Reynxldo/HealthBand/public/samuel.jpg

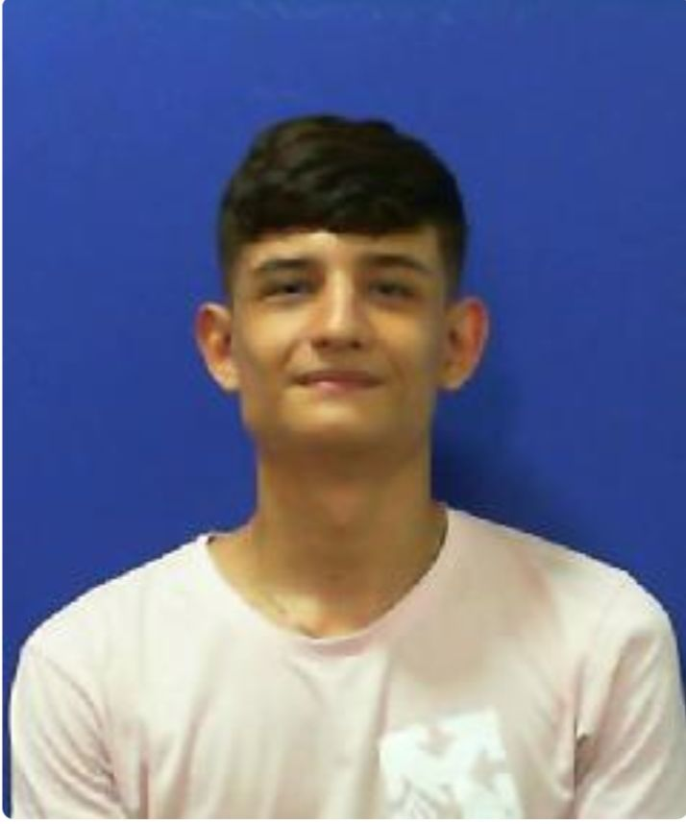
public/samuel.jpg
