Reynxldo/HealthBand/public/reynaldo.jpg

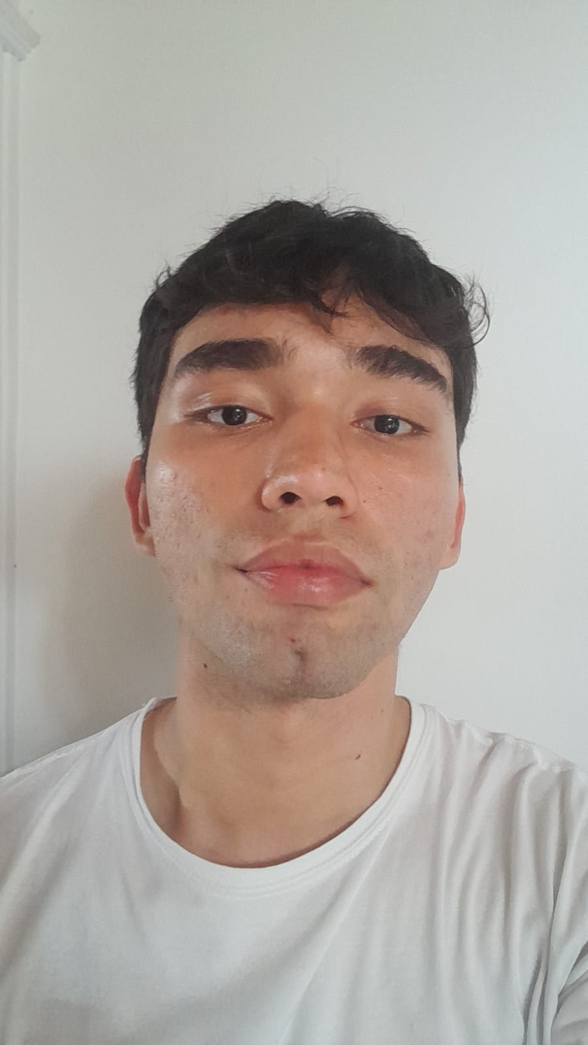
public/reynaldo.jpg
