Reynxldo/HealthBand/HealthBand_Proceso.docx

# Etapa 1 — Prueba Individual de Sensores

La primera etapa consistió en verificar el funcionamiento de cada sensor de forma independiente, antes de integrarlos en un mismo circuito.

## 1.1 Sensor MAX30100 (Ritmo Cardíaco y SpO2)

Se realizó la conexión básica del MAX30100 a la ESP32 mediante el bus I2C (GPIO 21 — SDA, GPIO 22 — SCL) con resistencias pull-up de 3.3kΩ hacia 3.3V. Se verificó que el sensor respondiera en la dirección I2C 0x57 mediante un sketch de escaneo de bus.

Se cargó un sketch de prueba con la librería MAX30100_PulseOximeter de OXullo, confirmando la inicialización correcta del sensor y la detección de latidos y SpO2 al colocar el dedo sobre el módulo. Se ajustó la corriente del LED infrarrojo a 27.1mA como valor óptimo entre precisión y temperatura del sensor.

Durante esta etapa se identificó que el módulo MAX30100 tiene resistencias pull-up internas a 1.8V, lo que generaría conflictos al compartir el bus I2C con el MLX90614 que opera a 3.3V.

## 1.2 Sensor MLX90614 (Temperatura Corporal)

Se realizó la conexión del MLX90614 al mismo bus I2C de prueba, verificando su respuesta en la dirección 0x5A. Se confirmó la lectura de temperatura ambiente y temperatura de objeto apuntando el sensor a diferentes superficies.

Se determinó que el sensor requiere un offset de +1.5°C para compensar la diferencia entre la temperatura superficial medida en muñeca y la temperatura corporal real, dado que la muñeca es una zona periférica con menor irrigación sanguínea.

# Etapa 2 — Integración de Ambos Sensores

Una vez verificados individualmente, se procedió a integrar ambos sensores en el mismo circuito conectados a la ESP32 simultáneamente.

## 2.1 Problema de Bus I2C Compartido

Al conectar ambos sensores al mismo bus I2C (GPIO 21/22), se presentaron conflictos generados por la diferencia de voltaje en las resistencias pull-up internas del MAX30100 (1.8V) frente a los niveles lógicos del MLX90614 (3.3V). Esto causaba que el MLX reportara valores NaN y que el MAX dejara de responder.

Se evaluaron varias soluciones incluyendo la remoción de resistencias internas del módulo MAX30100 y el uso de convertidores de nivel lógico. La solución definitiva adoptada fue el uso de dos buses I2C independientes en la ESP32.

## 2.2 Solución con Buses I2C Separados

Se configuró el MAX30100 en el Bus 0 (Wire, GPIO 21/22) y el MLX90614 en el Bus 1 (TwoWire(1), GPIO 25/26). Esta configuración eliminó completamente los conflictos entre sensores, permitiendo la operación simultánea y estable de ambos dispositivos.

- MAX30100: SDA → GPIO 21, SCL → GPIO 22, resistencias pull-up 4.7kΩ a 3.3V.
- MLX90614: SDA → GPIO 25, SCL → GPIO 26, sin resistencias externas adicionales.

## 2.3 Optimización del Algoritmo de Medición

Para estabilizar las lecturas del MAX30100 en muñeca, se implementaron las siguientes mejoras en el firmware:

- Buffer circular de 10 muestras para el promedio de BPM, aceptando solo valores entre 40 y 130 BPM.
- Tiempo de estabilización de 15 segundos al arrancar, durante el cual no se generan alertas.
- Persistencia de anomalía de 5 segundos: una condición debe mantenerse continua antes de disparar alerta.
- Manejo del loop sin delay() usando millis() para no interrumpir pox.update().
- Variable alertaPendiente para publicar alertas MQTT en el ciclo de 10 segundos sin bloquear el loop.

# Etapa 3 — Configuración del Broker MQTT

Con los sensores funcionando en conjunto, se procedió a implementar la comunicación IoT mediante el protocolo MQTT.

## 3.1 Selección y Configuración de HiveMQ Cloud

Se seleccionó HiveMQ Cloud como broker MQTT por su plan gratuito serverless, alta disponibilidad y soporte de conexiones TLS en el puerto 8883. Se creó una cuenta y se configuraron las credenciales de acceso.

Se configuró la ESP32 con la librería PubSubClient y WiFiClientSecure para establecer conexiones MQTT sobre TLS sin verificación de certificado (setInsecure()), lo que simplifica la implementación sin comprometer la funcionalidad del prototipo.

## 3.2 Tópicos MQTT Definidos

- pulsera/bpm — promedio de BPM de las últimas 10 muestras válidas.
- pulsera/spo2 — saturación de oxígeno en porcentaje.
- pulsera/temperatura — temperatura con offset aplicado.
- pulsera/alerta — texto de la alerta cuando se detecta una anomalía.

## 3.3 Verificación

Se verificó la llegada de datos al broker mediante el panel web de HiveMQ, confirmando la publicación correcta de los cuatro tópicos. Se ajustó el intervalo de publicación a 10 segundos para evitar bloqueos en el loop principal de la ESP32.

# Etapa 4 — Servidor Node.js y Dashboard Web

Con la ESP32 publicando datos al broker, se desarrolló la capa de software que recibe, almacena y visualiza la información en tiempo real.

## 4.1 ¿Por qué Node.js?

Node.js fue seleccionado como plataforma del servidor backend por las siguientes razones:

- Arquitectura asíncrona y no bloqueante, ideal para manejar simultáneamente MQTT, WebSocket, HTTP y base de datos sin bloqueos.
- Ecosistema npm con librerías especializadas para IoT: mqtt, express, ws y sqlite3, instalables con un solo comando.
- Uso de un único lenguaje (JavaScript) tanto en el servidor como en el frontend del dashboard.
- Bajo consumo de recursos, adecuado para correr en el mismo PC que sirve el dashboard.
- Soporte nativo de WebSockets para comunicación en tiempo real con el navegador sin polling.

## 4.2 Implementación del Servidor

Se desarrolló el archivo servidor.js integrando las siguientes funcionalidades en un único proceso:

- Cliente MQTT suscrito al tópico pulsera/# para recibir todos los datos de la ESP32.
- Base de datos SQLite con tablas para lecturas (bpm, spo2, temperatura, timestamp) y alertas.
- Servidor HTTP con Express sirviendo el dashboard en el puerto 3000 y una API REST en /api/historial y /api/alertas.
- Servidor WebSocket que reenvía en tiempo real los datos recibidos de MQTT a todos los clientes conectados.
- Bot de Telegram que envía notificaciones HTTP a la API de Telegram cuando llega una alerta.

## 4.3 Gestión con PM2

El servidor se configuró con PM2 (Process Manager 2) con un límite de reinicio automático de 150MB de memoria, evitando que una saturación del proceso interrumpa el monitoreo. Se configuró el arranque automático mediante un archivo arrancar.bat en la carpeta de inicio de Windows.

## 4.4 Dashboard Web — Primera Versión

Se desarrolló el dashboard en HTML5, CSS3 y JavaScript vanilla, sin frameworks adicionales. La primera versión incluía tres cards con valores en tiempo real (BPM, SpO2, temperatura), dos gráficas de línea con Chart.js mostrando las últimas 20 lecturas, y una tabla de historial consultada cada 10 segundos desde la API REST. La comunicación con el servidor se realizó mediante WebSocket con reconexión automática.

# Etapa 5 — Mejoras al Dashboard

Una vez validado el funcionamiento completo del sistema, se realizaron mejoras significativas al diseño y funcionalidad del dashboard web.

## 5.1 Sistema de Login

Se implementó una pantalla de login con autenticación simulada en el frontend, con tres usuarios predefinidos: admin (contraseña 1234), doctor (contraseña med123) y paciente (contraseña pac456). La pantalla incluye accesos rápidos mediante chips de usuario para facilitar las demostraciones.

## 5.2 Navegación por Secciones

Se agregó una barra de navegación superior con tres secciones accesibles sin recargar la página:

- Monitoreo: dashboard principal con cards, gráficas e historial en tiempo real.
- Recomendaciones médicas: guía de acción ante cada tipo de alerta del sistema (BPM elevado, SpO2 crítico, hipotermia, temperatura elevada) con aviso médico.
- Contáctanos: información de los tres integrantes del equipo y datos de la Universidad Surcolombiana.

## 5.3 Mejoras de Diseño

Se rediseñó completamente la interfaz con un esquema de colores oscuro profesional, tipografías Space Mono y DM Sans, cards con efectos de brillo por sensor, gráficas con colores diferenciados, historial con colores por columna y animaciones de transición en el login. El nombre del sistema en la interfaz web es VitalCore, mientras que el nombre del prototipo físico es HealthBand.

# Etapa 6 — Prueba de Alimentación Portátil

La etapa final consistió en validar el funcionamiento del sistema con alimentación de batería, de cara al prototipo portátil final.

Se utilizó una batería Li-Po de 3.7V 1000mAh conectada a un módulo elevador MT3608 calibrado a 5.5V, cuya salida se conectó al pin VIN de la ESP32. Inicialmente el sistema presentaba inestabilidad en el arranque debido a la demanda de corriente pico al conectar WiFi (aproximadamente 500mA).

Se resolvió parcialmente agregando dos capacitores electrolíticos de 1000µF en paralelo a la salida del MT3608, que actúan como reserva de corriente instantánea durante el arranque. El sistema logró funcionar con batería, confirmado por la recepción de alertas en Telegram durante las pruebas.

Para el prototipo final se recomienda utilizar una batería de mayor capacidad (2000mAh o más) junto con el módulo cargador TP4056 de 6 pines para protección contra sobredescarga, como estaba planificado en el diseño original.

# Resumen de Etapas

# | Etapa | Resultado

1 | Prueba individual de sensores | MAX30100 y MLX90614 verificados por separado. Identificado conflicto de voltaje en bus I2C compartido.
2 | Integración de sensores | Solución con buses I2C separados. Firmware con promedio, estabilización y persistencia de alertas.
3 | Configuración broker MQTT | HiveMQ Cloud configurado. Cuatro tópicos publicados correctamente desde la ESP32.
4 | Servidor Node.js y dashboard | Servidor con MQTT, WebSocket, SQLite y Telegram. Dashboard con gráficas en tiempo real.
5 | Mejoras al dashboard | Login simulado, navegación por secciones, rediseño visual completo.
6 | Prueba de alimentación portátil | Sistema funcionando con batería Li-Po + MT3608 + capacitores. Pendiente batería 2000mAh para versión final.

Universidad Surcolombiana — Ingeniería Electrónica — 2025

HealthBand — Proceso de Desarrollo
