Reynxldo/HealthBand/Proyecto_salud.docx

PROYECTO FINAL

MONITOREO DE SIGNOS VITALES CON IOT Y ESP32

CON PULSERA PORTABLE:

HEALTHYBAND

Reynaldo Medina Cabrera 20241221327

Juan Andrés Urrea Cediel 20241223061

Samuel Pérez Chinchilla 20241222057

Resumen-

Palabras claves-

REFERENCIAS:

Proyecto: HealthyBand P R O G R A M A D E I N G E N I E R I A E L E C T R O N I C A

F A C U L T A D D E I N G E N I E R I A 20 DE MARZO DEL 2026
