Reynxldo/HealthBand/public/juan.jpg

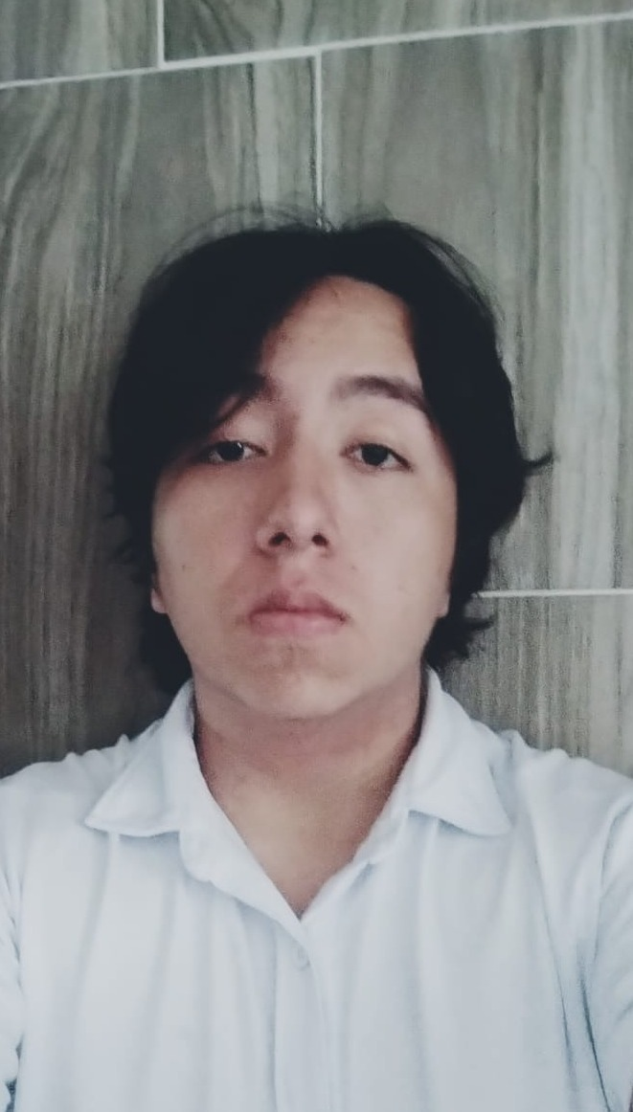
public/juan.jpg
