Reynxldo/HealthBand/HEALTH BAND_FINAL.pdf

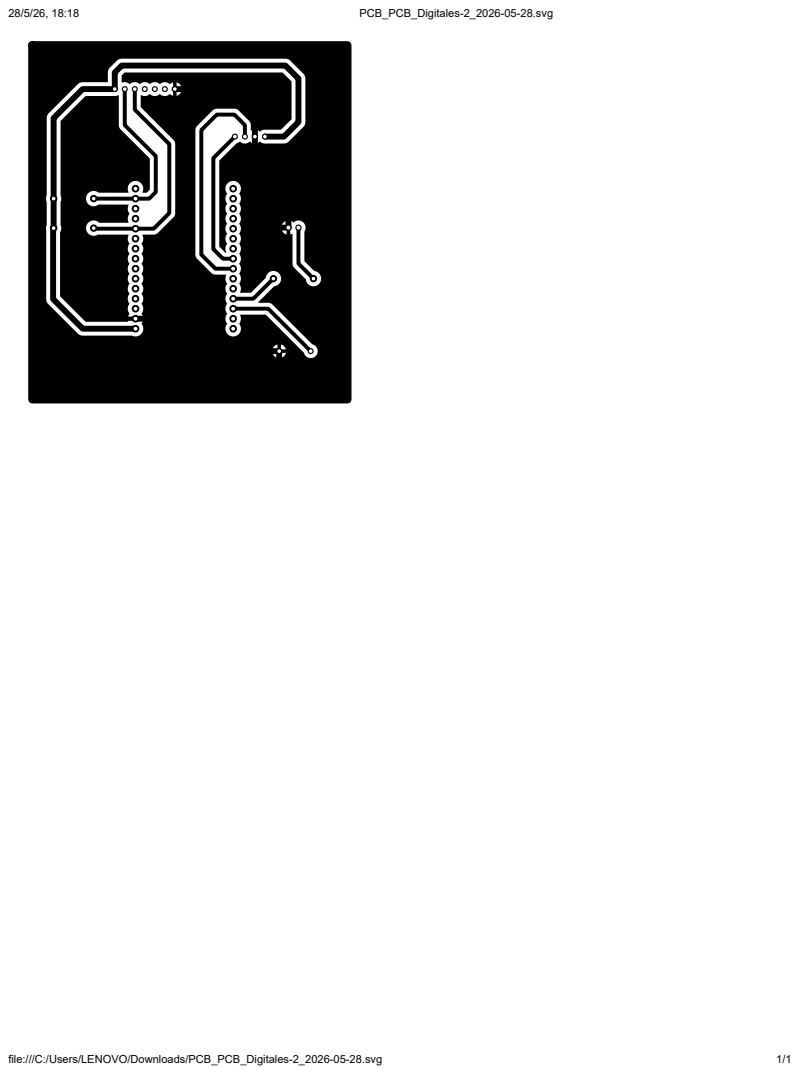
[picture p4: page 1]
PCB_PCB_Digitales-2_2026-05-28.svg; file:///C:/Users/LENOVO/Downloads/PCB_PCB_Digitales-2_2026-05-28.svg
