Reynxldo/HealthBand/PCB_HEALTH.pdf

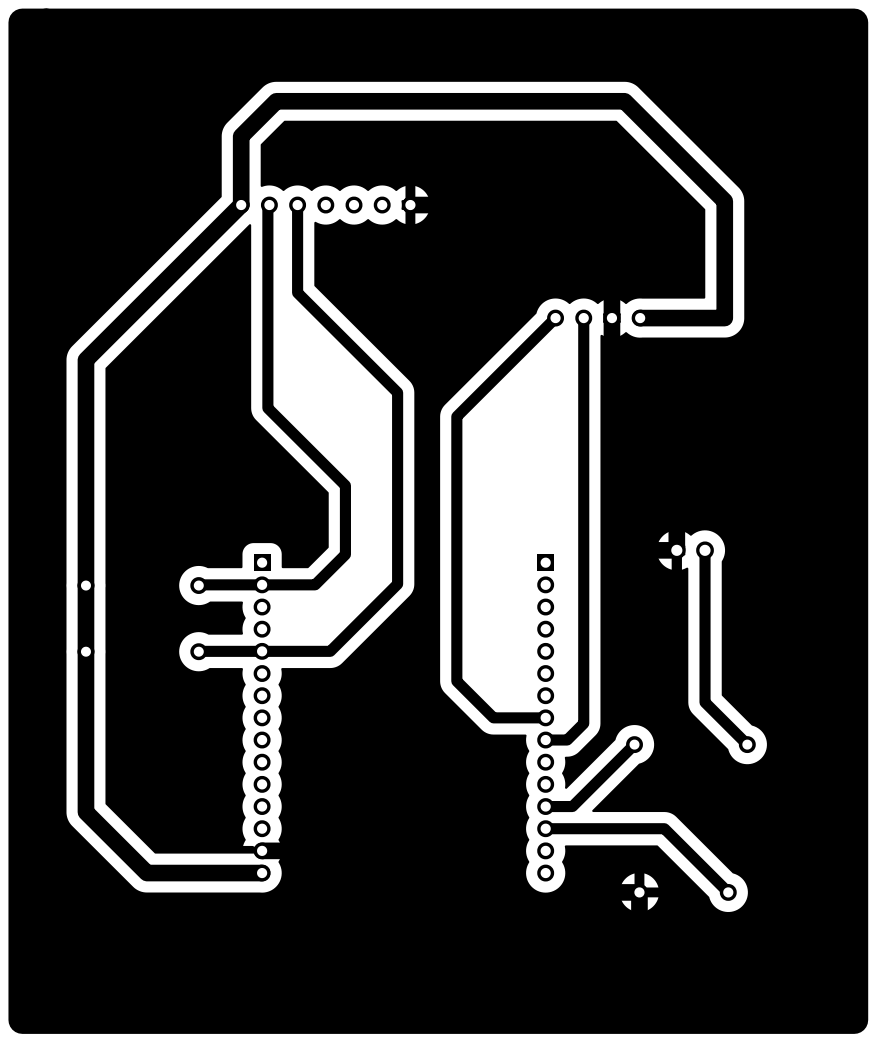
[picture p5: page 1]
