Reynxldo/HealthBand/placa_1.pdf

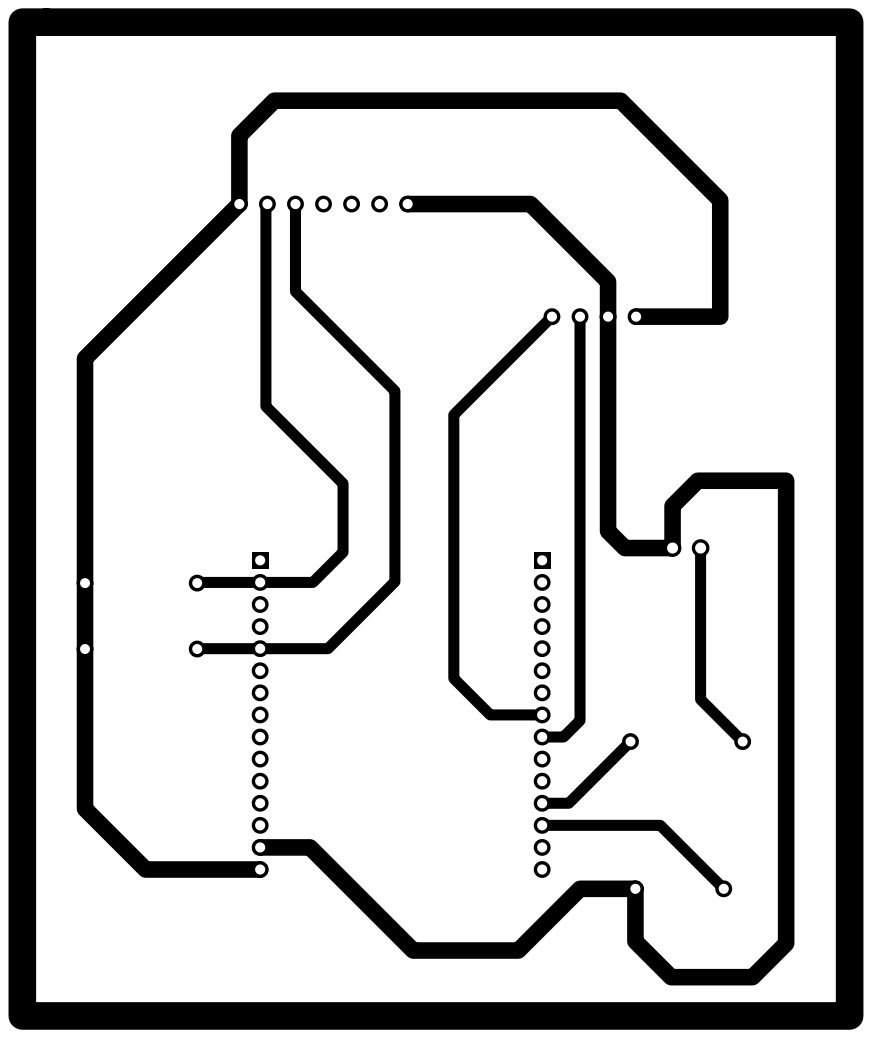
[picture p6: page 1]
