Reynxldo/HealthBand/proto_7/proto_7.ino

#include <Wire.h>
#include <Adafruit_MLX90614.h>
#include "MAX30100_PulseOximeter.h"
#include <WiFi.h>
#include <PubSubClient.h>
#include <WiFiClientSecure.h>

// WiFi
const char* ssid     = "iPhone de Samuel";
const char* password = "samuel01";

// HiveMQ
const char* mqtt_server   = "561ca56c1b5a4b978b24893f8b8a49c4.s1.eu.hivemq.cloud";
const int   mqtt_port     = 8883;
const char* mqtt_user     = "Caozinho369";
const char* mqtt_password = "Yrc5P@bmFgEUEbD";

#define PIN_LED    12
#define PIN_BUZZER 13

TwoWire I2C_MLX = TwoWire(1);

Adafruit_MLX90614 mlx = Adafruit_MLX90614();
PulseOximeter pox;

WiFiClientSecure espClient;
PubSubClient client(espClient);

uint32_t lastReport      = 0;
uint32_t lastTempRead    = 0;
uint32_t lastBuzzer      = 0;
uint32_t tiempoInicio    = 0;
uint32_t lastMqttPublish = 0;
bool buzzerActivo        = false;
bool buzzerEstado        = false;
int  buzzerContador      = 0;

uint32_t inicioBpmAlto  = 0;
uint32_t inicioSpo2Bajo = 0;
uint32_t inicioTempAlta = 0;
uint32_t inicioTempBaja = 0;
bool bpmAltoActivo      = false;
bool spo2BajoActivo     = false;
bool tempAltaActiva     = false;
bool tempBajaActiva     = false;

String alertaPendiente = "";
volatile bool latidoDetectado = false;

#define TIEMPO_ESTABILIZACION  15000
#define TIEMPO_PERSISTENCIA     5000

float offset = 1.5;

#define BPM_MUESTRAS 10
float bpmBuffer[BPM_MUESTRAS] = {0};
int bpmIndex = 0;
int bpmCount = 0;

float ultimaBpm  = 0;
float ultimaSpo2 = 0;
float ultimaTemp = 0;

#define SPO2_MINIMO   90.0
#define BPM_MAXIMO   100.0
#define TEMP_MAXIMA   37.5
#define TEMP_MINIMA   34.8

void onBeatDetected() {
  latidoDetectado = true;
}

void alertaBuzzer() {
  if (buzzerActivo) return;
  buzzerActivo   = true;
  buzzerEstado   = true;
  buzzerContador = 0;
  lastBuzzer     = millis();
  digitalWrite(PIN_BUZZER, HIGH);
}

void manejarBuzzer() {
  if (!buzzerActivo) return;
  uint32_t ahora = millis();
  if (buzzerEstado && ahora - lastBuzzer > 300) {
    buzzerEstado = false;
    digitalWrite(PIN_BUZZER, LOW);
    lastBuzzer = ahora;
  } else if (!buzzerEstado && ahora - lastBuzzer > 200) {
    buzzerContador++;
    if (buzzerContador >= 2) {
      buzzerActivo = false;
      buzzerEstado = false;
      digitalWrite(PIN_BUZZER, LOW);
    } else {
      buzzerEstado = true;
      digitalWrite(PIN_BUZZER, HIGH);
      lastBuzzer = ahora;
    }
  }
}

float calcularPromedioBPM() {
  if (bpmCount == 0) return 0;
  float suma = 0;
  int total = min(bpmCount, BPM_MUESTRAS);
  for (int i = 0; i < total; i++) suma += bpmBuffer[i];
  return suma / total;
}

bool sistemaEstabilizado() {
  return (millis() - tiempoInicio) >= TIEMPO_ESTABILIZACION;
}

void conectarWifi() {
  Serial.print("Conectando a WiFi");
  WiFi.begin(ssid, password);
  while (WiFi.status() != WL_CONNECTED) {
    delay(500);
    Serial.print(".");
  }
  Serial.println("\nWiFi conectado — IP: " + WiFi.localIP().toString());
}

void conectarMQTT() {
  espClient.setInsecure();
  client.setServer(mqtt_server, mqtt_port);
  client.setSocketTimeout(5);
  while (!client.connected()) {
    Serial.print("Conectando a HiveMQ...");
    String clientId = "ESP32Pulsera-" + String(random(0xffff), HEX);
    if (client.connect(clientId.c_str(), mqtt_user, mqtt_password)) {
      Serial.println(" conectado");
    } else {
      Serial.print(" fallo rc=");
      Serial.println(client.state());
      delay(2000);
    }
  }
}

void publicarMQTT() {
  if (!client.connected()) conectarMQTT();
  char buffer[10];
  dtostrf(ultimaBpm,  4, 1, buffer);
  client.publish("pulsera/bpm", buffer);
  dtostrf(ultimaSpo2, 4, 1, buffer);
  client.publish("pulsera/spo2", buffer);
  dtostrf(ultimaTemp, 4, 1, buffer);
  client.publish("pulsera/temperatura", buffer);
  Serial.println("→ Datos enviados a HiveMQ");
}

void verificarAnomaliaBpm(float bpmPromedio) {
  if (bpmPromedio > BPM_MAXIMO) {
    if (!bpmAltoActivo) {
      bpmAltoActivo = true;
      inicioBpmAlto = millis();
    } else if (millis() - inicioBpmAlto >= TIEMPO_PERSISTENCIA) {
      Serial.println("  → BPM elevado ⚠");
      alertaPendiente = "BPM elevado";
      alertaBuzzer();
      bpmAltoActivo = false;
      inicioBpmAlto = 0;
    }
  } else {
    bpmAltoActivo = false;
    inicioBpmAlto = 0;
  }
}

void verificarAnomaliaSpo2(float spo2) {
  if (spo2 > 0 && spo2 < SPO2_MINIMO) {
    if (!spo2BajoActivo) {
      spo2BajoActivo = true;
      inicioSpo2Bajo = millis();
    } else if (millis() - inicioSpo2Bajo >= TIEMPO_PERSISTENCIA) {
      Serial.println("  → SpO2 crítico ⚠");
      alertaPendiente = "SpO2 critico";
      alertaBuzzer();
      spo2BajoActivo = false;
      inicioSpo2Bajo = 0;
    }
  } else {
    spo2BajoActivo = false;
    inicioSpo2Bajo = 0;
  }
}

void verificarAnomaliaTemp(float temp) {
  if (temp > TEMP_MAXIMA) {
    if (!tempAltaActiva) {
      tempAltaActiva = true;
      inicioTempAlta = millis();
    } else if (millis() - inicioTempAlta >= TIEMPO_PERSISTENCIA) {
      Serial.println("  → Temperatura elevada ⚠");
      alertaPendiente = "Temperatura elevada";
      alertaBuzzer();
      tempAltaActiva = false;
      inicioTempAlta = 0;
    }
    tempBajaActiva = false;
    inicioTempBaja = 0;
  } else if (temp >= 20.0 && temp < TEMP_MINIMA) {
    if (!tempBajaActiva) {
      tempBajaActiva = true;
      inicioTempBaja = millis();
    } else if (millis() - inicioTempBaja >= TIEMPO_PERSISTENCIA) {
      Serial.println("  → Hipotermia ⚠");
      alertaPendiente = "Hipotermia";
      alertaBuzzer();
      tempBajaActiva = false;
      inicioTempBaja = 0;
    }
    tempAltaActiva = false;
    inicioTempAlta = 0;
  } else {
    tempAltaActiva = false;
    inicioTempAlta = 0;
    tempBajaActiva = false;
    inicioTempBaja = 0;
  }
}

void setup() {
  Serial.begin(115200);
  delay(1000);

  pinMode(PIN_LED,    OUTPUT);
  pinMode(PIN_BUZZER, OUTPUT);
  digitalWrite(PIN_LED,    HIGH);
  digitalWrite(PIN_BUZZER, LOW);

  conectarWifi();

  Wire.begin(21, 22);
  Wire.setClock(100000);

  if (!pox.begin()) {
    Serial.println("Error: MAX30100 no detectado");
    while (1);
  }
  pox.setIRLedCurrent(MAX30100_LED_CURR_27_1MA);
  pox.setOnBeatDetectedCallback(onBeatDetected);
  Serial.println("MAX30100 OK");

  delay(500);

  I2C_MLX.begin(25, 26);
  I2C_MLX.setClock(100000);

  if (!mlx.begin(0x5A, &I2C_MLX)) {
    Serial.println("Error: MLX90614 no detectado");
    while (1);
  }
  Serial.println("MLX90614 OK");

  conectarMQTT();

  tiempoInicio = millis();

  Serial.println("Sistema listo");
  Serial.println("------------------------");
}

void loop() {
  pox.update();
  manejarBuzzer();

  if (latidoDetectado) {
    Serial.println("♥ Latido");
    latidoDetectado = false;
  }

  if (millis() - lastReport > 1000) {
    float bpm  = pox.getHeartRate();
    float spo2 = pox.getSpO2();

    if (bpm >= 40 && bpm <= 130) {
      bpmBuffer[bpmIndex] = bpm;
      bpmIndex = (bpmIndex + 1) % BPM_MUESTRAS;
      bpmCount++;
    }

    float bpmPromedio = calcularPromedioBPM();
    ultimaBpm  = bpmPromedio;
    ultimaSpo2 = spo2;

    Serial.print("BPM: "); Serial.print(bpmPromedio, 1);
    Serial.print("  |  SpO2: "); Serial.print(spo2, 1); Serial.print(" %");

    if (bpm == 0) {
      Serial.println("  → Sin dedo");
      bpmCount       = 0;
      bpmIndex       = 0;
      bpmAltoActivo  = false;
      spo2BajoActivo = false;
    } else if (bpmPromedio == 0) {
      Serial.println("  → Leyendo...");
    } else if (bpmPromedio <= BPM_MAXIMO) {
      Serial.println("  → Normal");
      bpmAltoActivo = false;
    } else {
      if (sistemaEstabilizado()) {
        verificarAnomaliaBpm(bpmPromedio);
      } else {
        Serial.println("  → Estabilizando...");
      }
    }

    if (sistemaEstabilizado()) {
      verificarAnomaliaSpo2(spo2);
    }

    lastReport = millis();
  }

  if (millis() - lastTempRead > 2000) {
    float temp = mlx.readObjectTempC() + offset;
    ultimaTemp = temp;

    Serial.print("Temperatura: "); Serial.print(temp, 1); Serial.print(" °C");

    if (temp < 20.0) {
      Serial.println("  → Sin contacto");
      tempAltaActiva = false;
      tempBajaActiva = false;
    } else if (temp >= TEMP_MINIMA && temp <= TEMP_MAXIMA) {
      Serial.println("  → Normal");
      tempAltaActiva = false;
      tempBajaActiva = false;
    } else {
      if (sistemaEstabilizado()) {
        verificarAnomaliaTemp(temp);
      } else {
        Serial.println("  → Estabilizando...");
      }
    }

    lastTempRead = millis();
  }

  if (millis() - lastMqttPublish > 10000) {
    client.loop();
    if (ultimaBpm > 0) publicarMQTT();
    if (alertaPendiente != "") {
      client.publish("pulsera/alerta", alertaPendiente.c_str());
      alertaPendiente = "";
    }
    lastMqttPublish = millis();
  }

  pox.update();
}
