Reynxldo/HealthBand/(commit log)

2026-05-24 websocket railway
2026-05-24 Cambio de diseño
